HunterGleason/HYDROS21/(commit log)

2022-04-27 Added parameter file ability and wiring diagram, incomplete, tested in lab, appears to be working, not deployed
2022-05-02 Finalized wiring diagram
2022-05-02 Updated README, slight modifications to error codes in HYDROS21.ino
    [HYDROS21.ino]
2022-05-25 Trying to fix every-other-day Iridium transmission, no luck
    [HYDROS21.ino]
2022-05-30 Still trying to fix ever-other-day send, test failed
    [HYDROS21.ino]
2022-06-13 Changed paramter file ingestion types from int to uint32_t, seems to have solved issue with transmission time update
    [HYDROS21.ino]
2022-06-17 Fixed minor bugs, as in turbidity version
    [HYDROS21.ino]
2022-06-20 Fixed every-other transmission issue
    [HYDROS21.ino]
2022-07-15 Changed sample frequncy param from seconds to minutes, code now retains HOURLY.CSV in case of failed IRIDIUM transmission, allowing data to be sent on next try (assuming < 340 bites)
    [HYDROS21.ino]
2022-08-02 Changed send_hourly_iridium to try once more if transmission fails with extended timeout instead of 3 attempts
    [HYDROS21.ino]
